memorez1000enjoyer/CASA-EDB/output/renders/exploded.png

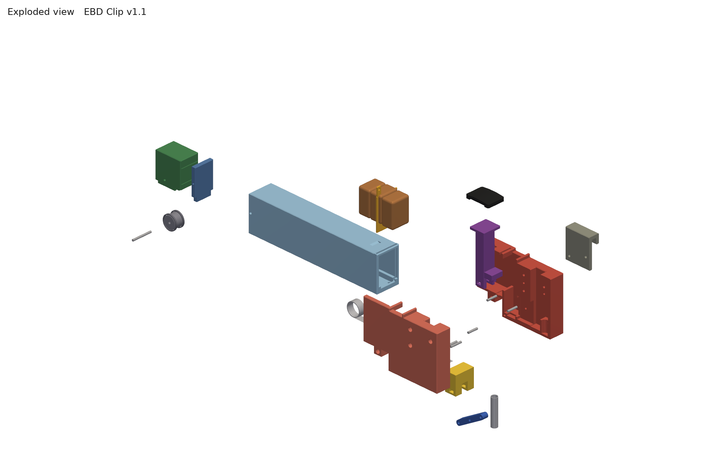
output/renders/exploded.png
