memorez1000enjoyer/CASA-EDB/output/renders/state_A_rest_full_iso_back.png

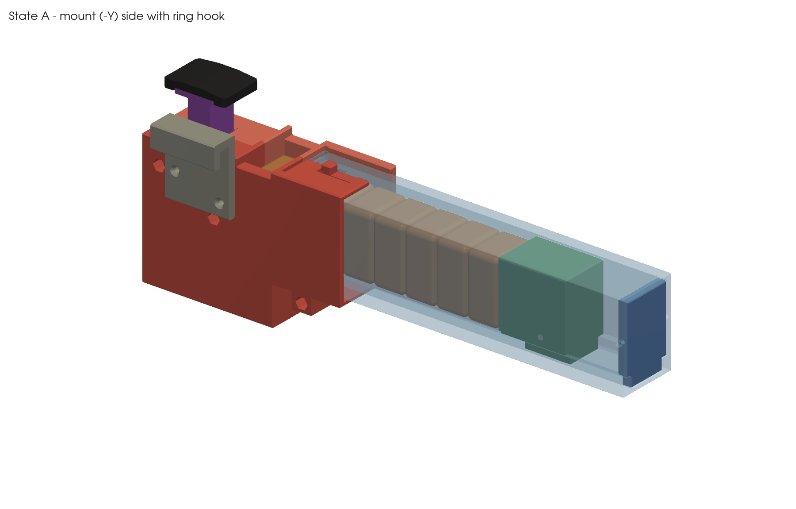
output/renders/state_A_rest_full_iso_back.png
