memorez1000enjoyer/CASA-EDB/output/renders/state_A_rest_full_section_Y0_zoom.png

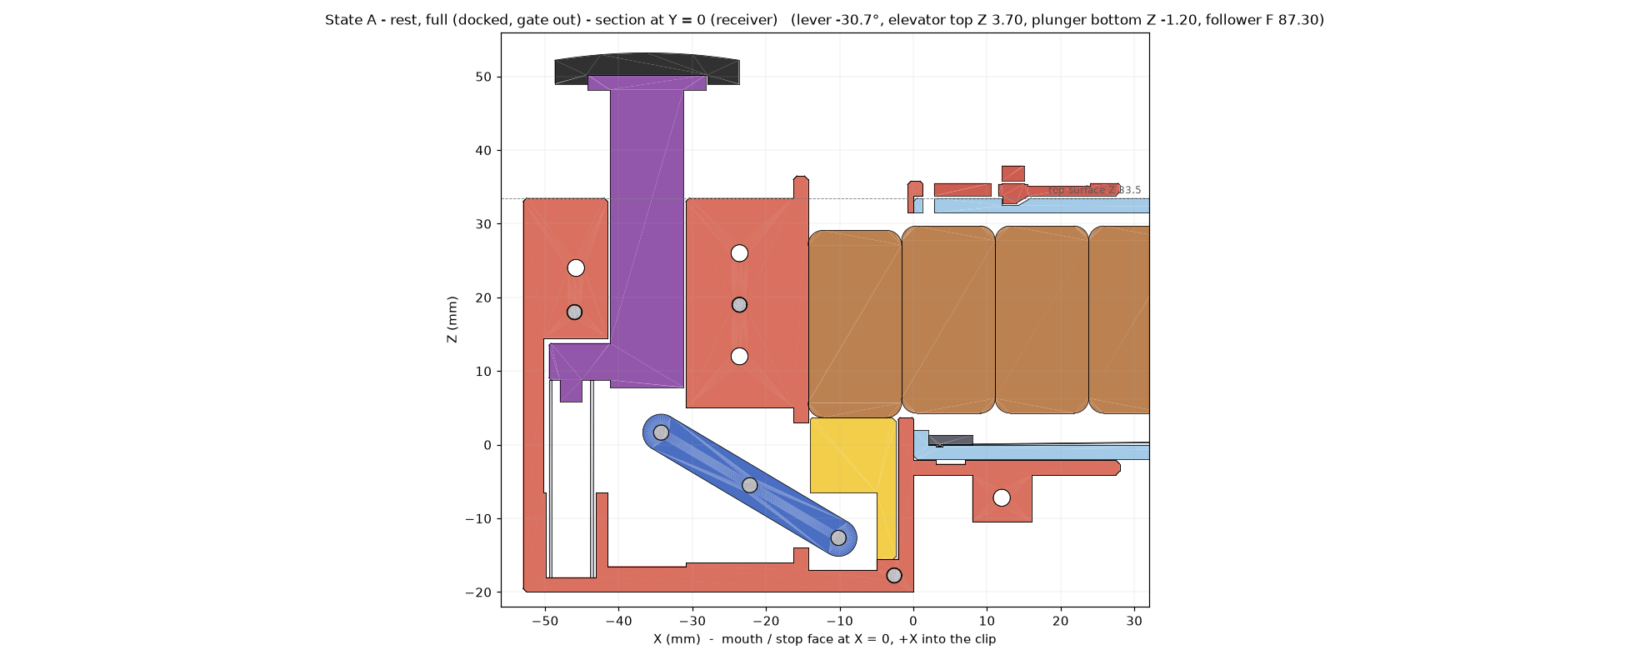
output/renders/state_A_rest_full_section_Y0_zoom.png
