memorez1000enjoyer/CASA-EDB/output/renders/state_Bprime_pressed_bite1_taken_iso.png

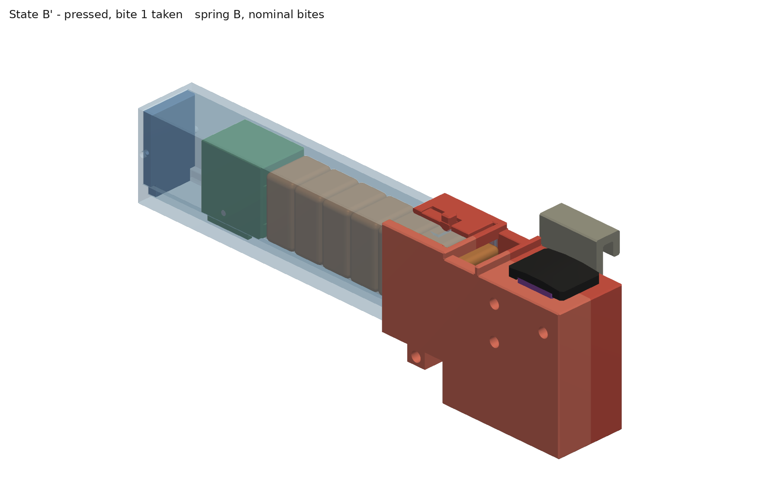
output/renders/state_Bprime_pressed_bite1_taken_iso.png
