memorez1000enjoyer/CASA-EDB/output/renders/state_Bprime_pressed_bite1_taken_section_Y0_zoom.png

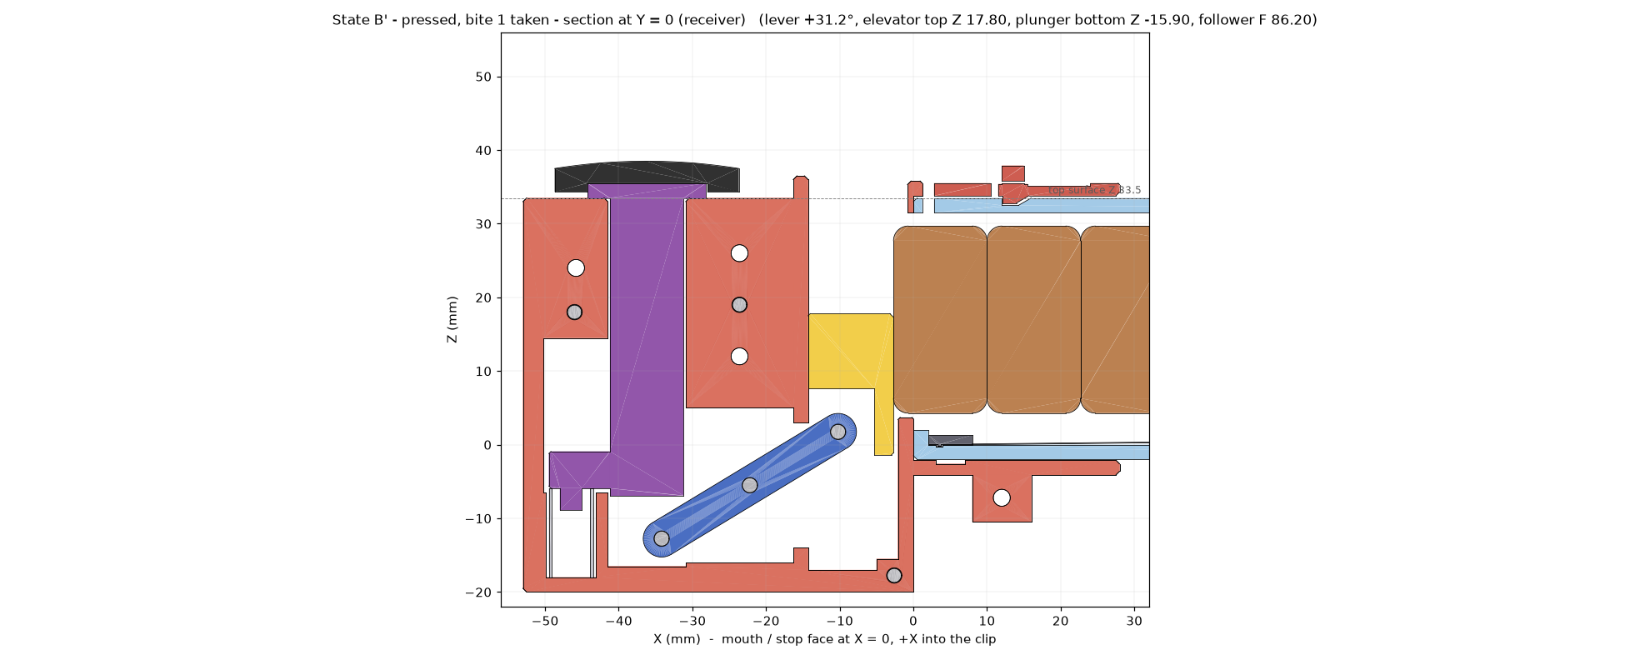
output/renders/state_Bprime_pressed_bite1_taken_section_Y0_zoom.png
