memorez1000enjoyer/CASA-EDB/output/renders/state_C_section_Y0.png

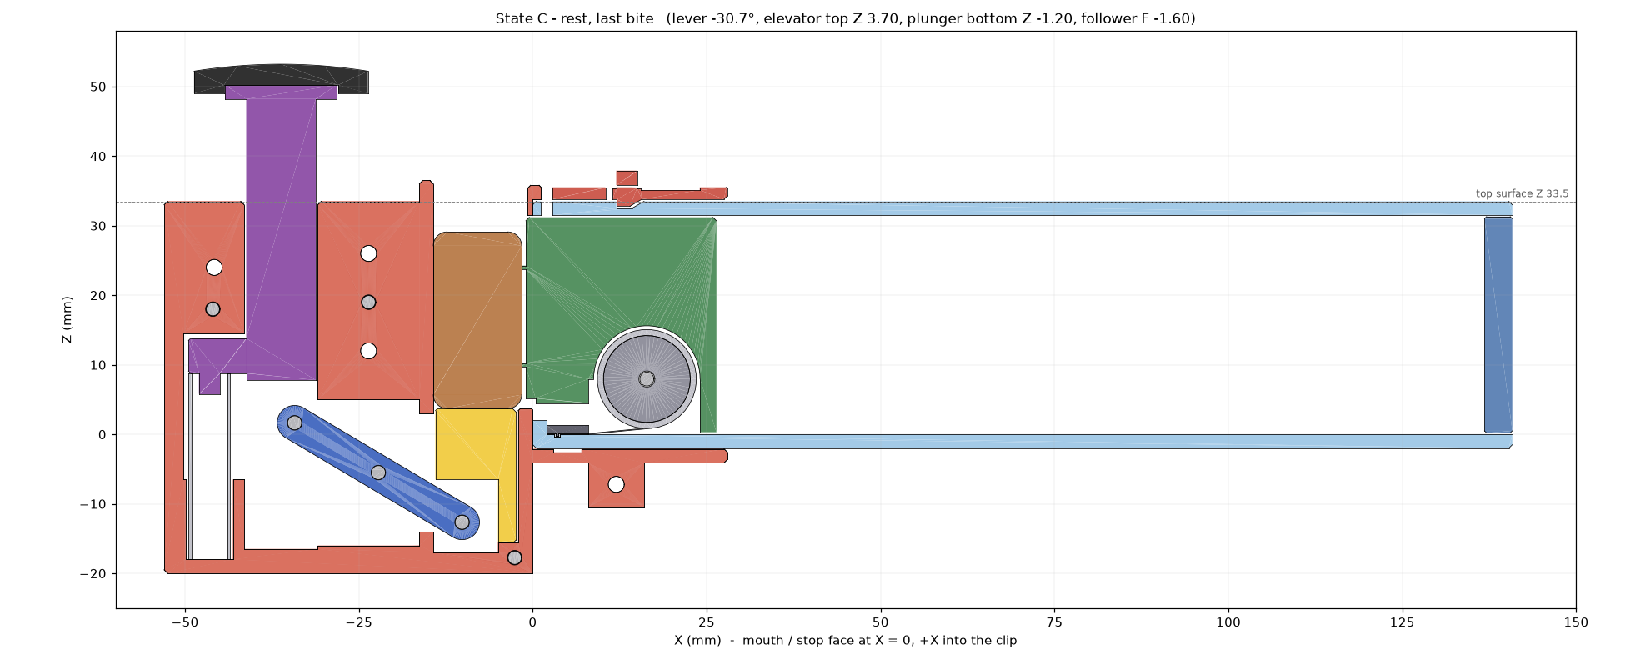
output/renders/state_C_section_Y0.png
