memorez1000enjoyer/CASA-EDB/output/step/parts/end_cap.step

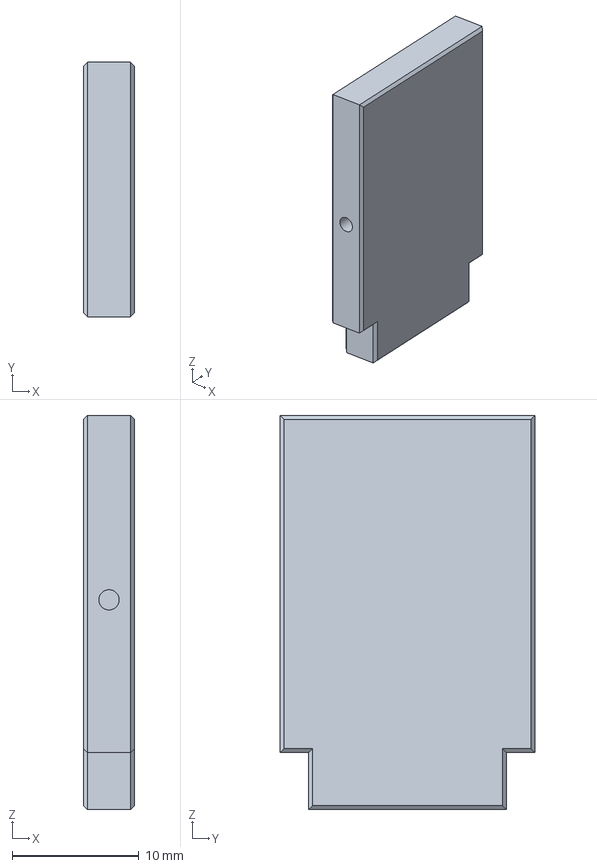
[picture p14: CAD file, 2026-10-06]
output/step/parts/end_cap.step
4.00 x 20.1 x 31.1 mm
