memorez1000enjoyer/CASA-EDB/output/stl/slicer_helpers/receiver_left_SUPPORT_ENFORCER.stl

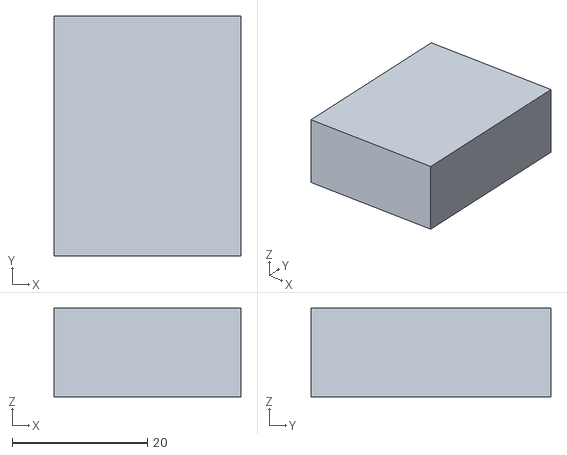
[picture p15: CAD file, 2026-10-06]
output/stl/slicer_helpers/receiver_left_SUPPORT_ENFORCER.stl
27.6 x 35.5 x 13.2
