memorez1000enjoyer/CASA-EDB/output/step/parts/clip_tube.step

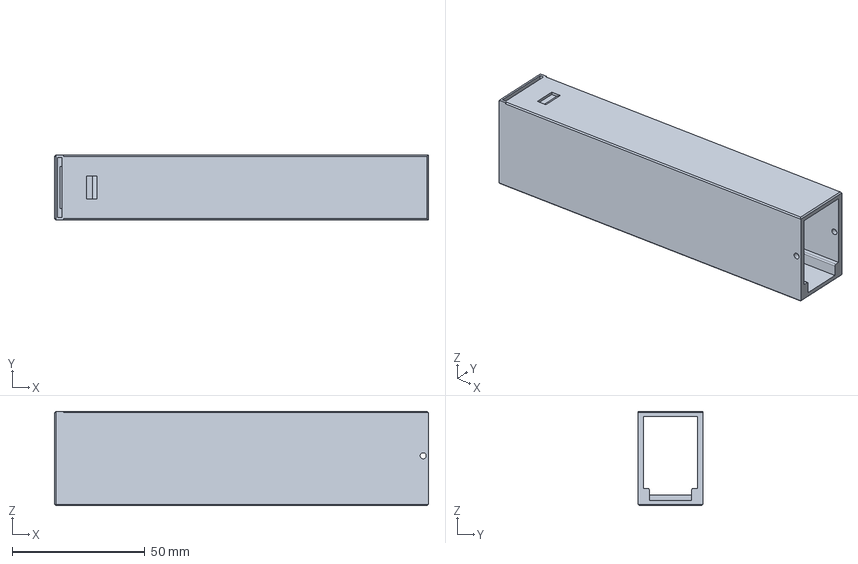
[picture p17: CAD file, 2026-10-06]
output/step/parts/clip_tube.step
140.8 x 24.5 x 35.5 mm
