memorez1000enjoyer/CASA-EDB/output/step/parts/receiver_left.step

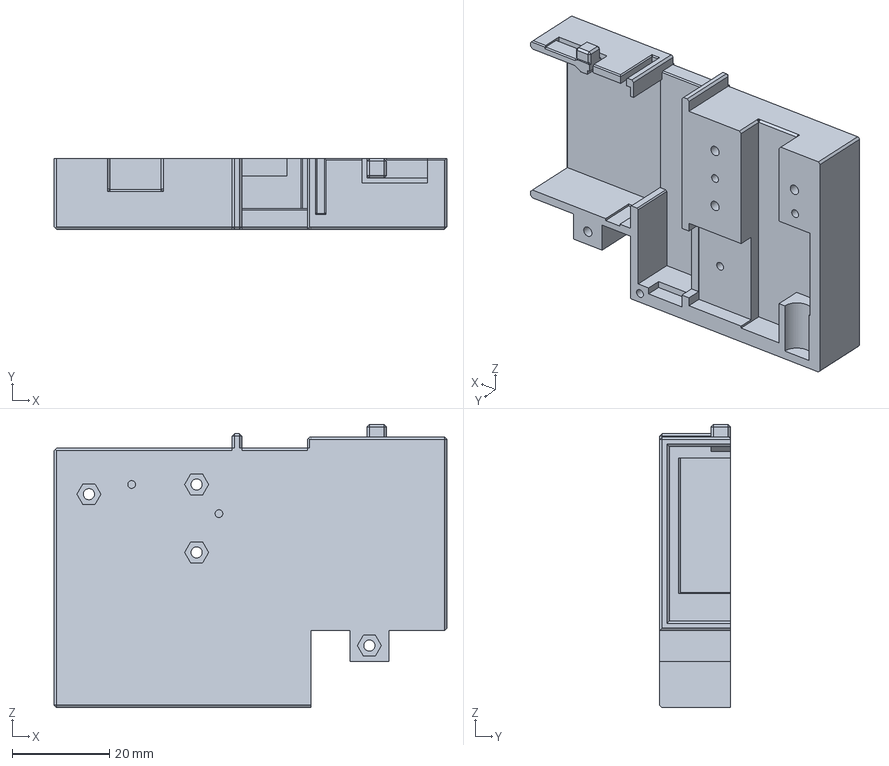
[picture p20: CAD file, 2026-10-06]
output/step/parts/receiver_left.step
81.0 x 14.6 x 58.4 mm
