memorez1000enjoyer/CASA-EDB/output/stl/slicer_helpers/plunger_SUPPORT_ENFORCER.stl

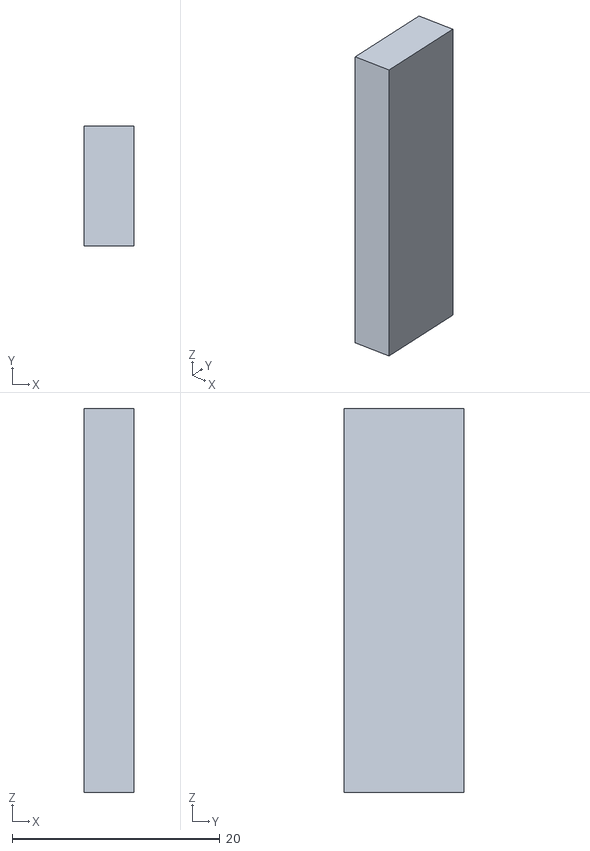
[picture p21: CAD file, 2026-09-29]
output/stl/slicer_helpers/plunger_SUPPORT_ENFORCER.stl
4.80 x 11.6 x 37.0
