memorez1000enjoyer/CASA-EDB/output/step/parts/follower_springA.step

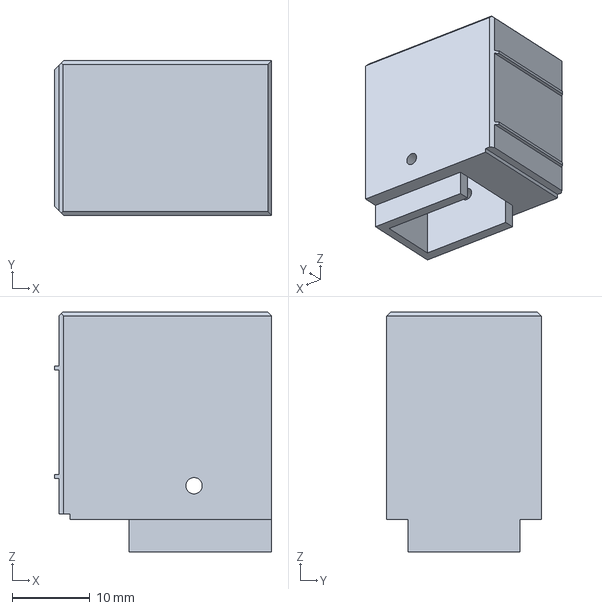
[picture p23: CAD file, 2026-10-06]
output/step/parts/follower_springA.step
28.0 x 19.9 x 30.9 mm
