memorez1000enjoyer/CASA-EDB/output/step/assemblies/state_E_springB_nom.step

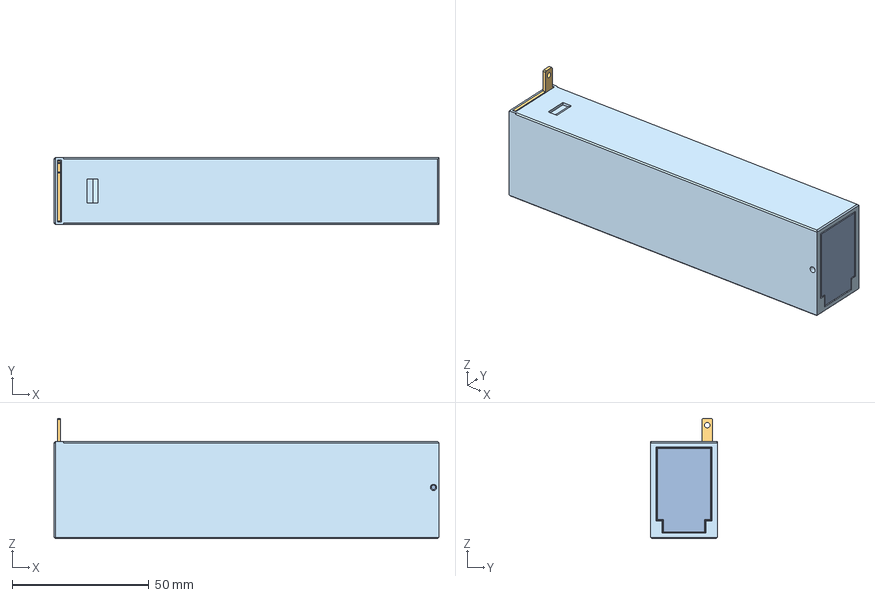
[picture p24: CAD file, 2026-10-06]
output/step/assemblies/state_E_springB_nom.step
140.8 x 24.5 x 44.0 mm
clip_tube
end_cap
ribbon_clamp
screw_clamp_p
screw_clamp_n
gate
follower
drum
pin_axle
drum_spacer1
drum_spacer2
cf_spring
bite1
bite2
bite3
bite4
bite5
bite6
bite7
bite8
