memorez1000enjoyer/CASA-EDB/output/step/parts/plunger.step

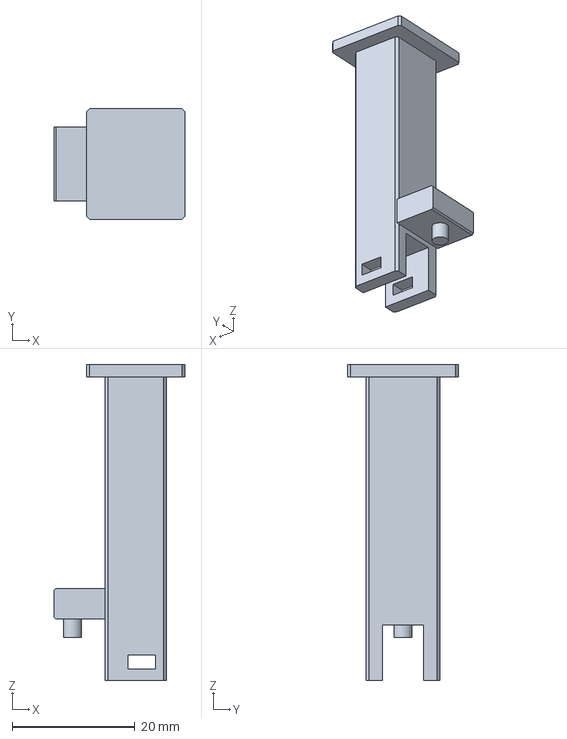
[picture p25: CAD file, 2026-10-06]
output/step/parts/plunger.step
21.3 x 18.0 x 51.4 mm
