memorez1000enjoyer/CASA-EDB/output/step/assemblies/state_Bprime_springB_nom.step

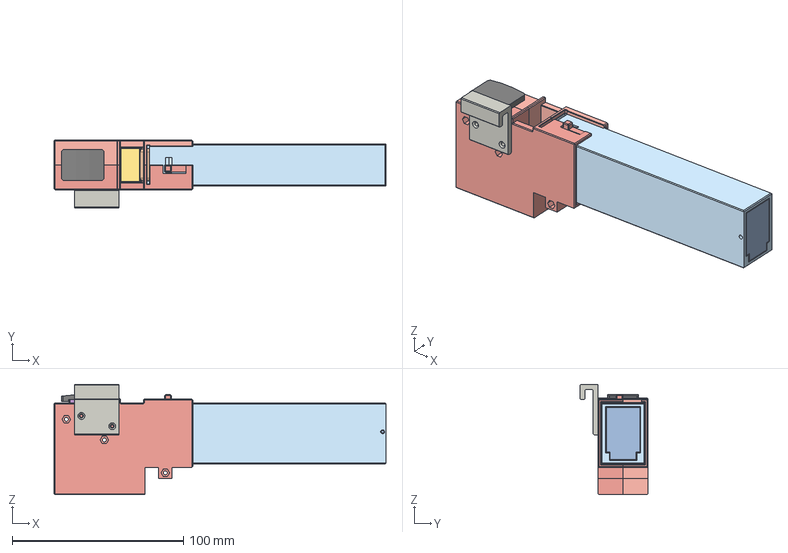
[picture p26: CAD file, 2026-10-06]
output/step/assemblies/state_Bprime_springB_nom.step
193.8 x 39.7 x 64.5 mm
clip_tube
end_cap
ribbon_clamp
screw_clamp_p
screw_clamp_n
follower
drum
pin_axle
drum_spacer1
drum_spacer2
cf_spring
receiver_left
receiver_right
ring_hook
dowel1
dowel2
dowel3
pin_pivot
elevator
lever
pin_cup
pin_plunger
plunger
paddle_pad
return_spring
bite2
bite3
bite4
bite5
bite6
bite7
bite8
