memorez1000enjoyer/CASA-EDB/output/step/parts/gate.step

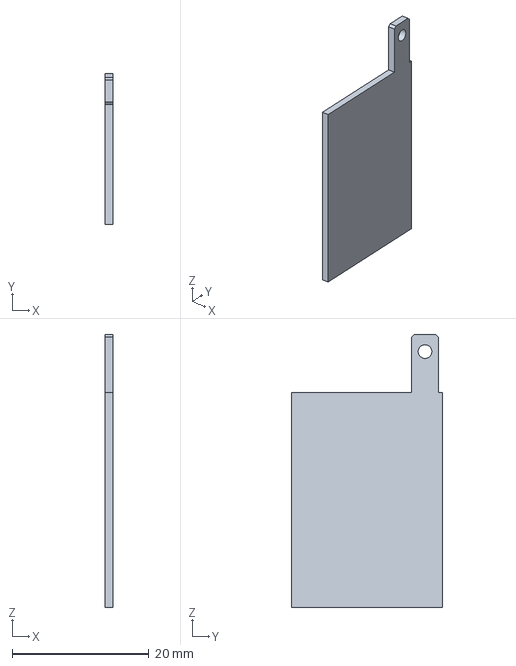
[picture p27: CAD file, 2026-10-06]
output/step/parts/gate.step
1.20 x 22.1 x 40.0 mm
