memorez1000enjoyer/CASA-EDB/output/step/parts/lever.step

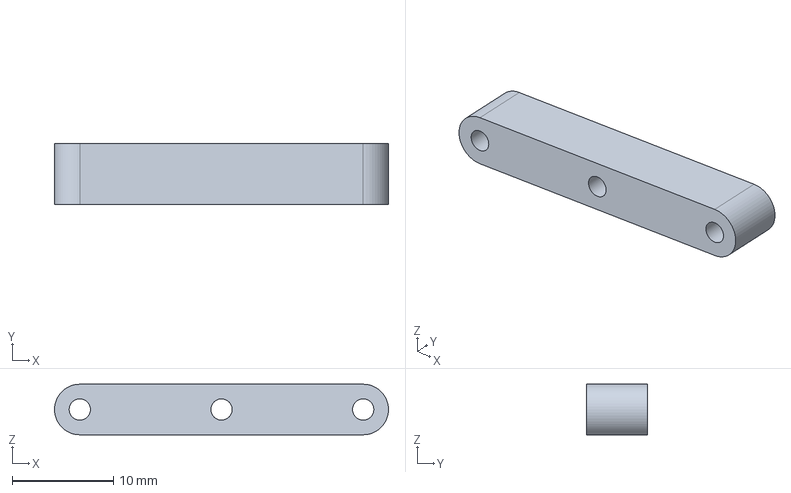
[picture p29: CAD file, 2026-10-06]
output/step/parts/lever.step
33.0 x 6.00 x 5.00 mm
