memorez1000enjoyer/CASA-EDB/output/step/parts/bite_min.step

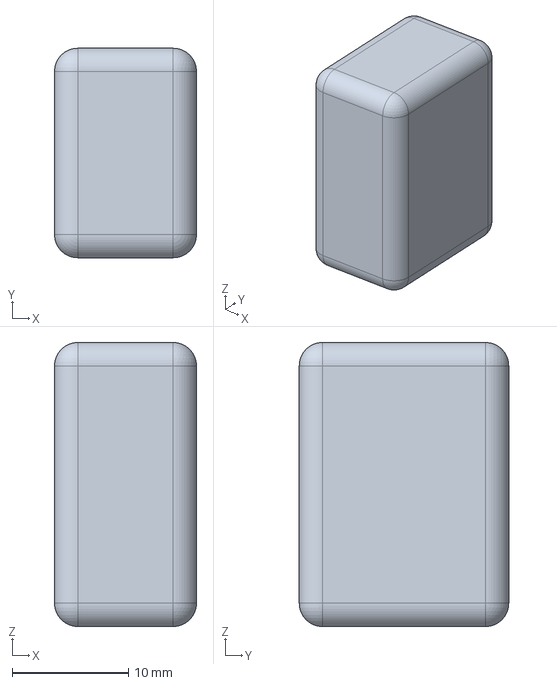
[picture p31: CAD file, 2026-10-06]
output/step/parts/bite_min.step
12.2 x 18.0 x 24.4 mm
