memorez1000enjoyer/CASA-EDB/output/step/parts/bite_max.step

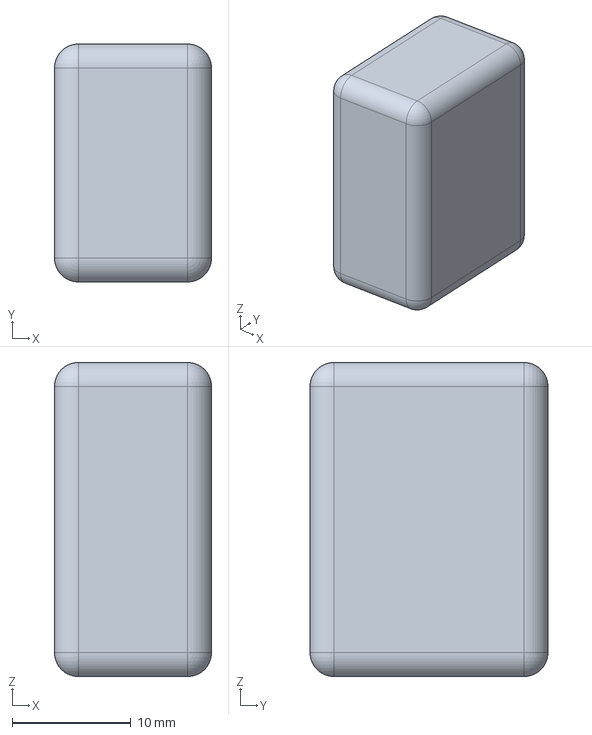
[picture p33: CAD file, 2026-10-06]
output/step/parts/bite_max.step
13.2 x 20.0 x 26.4 mm
