memorez1000enjoyer/CASA-EDB/output/step/parts/ring_hook.step

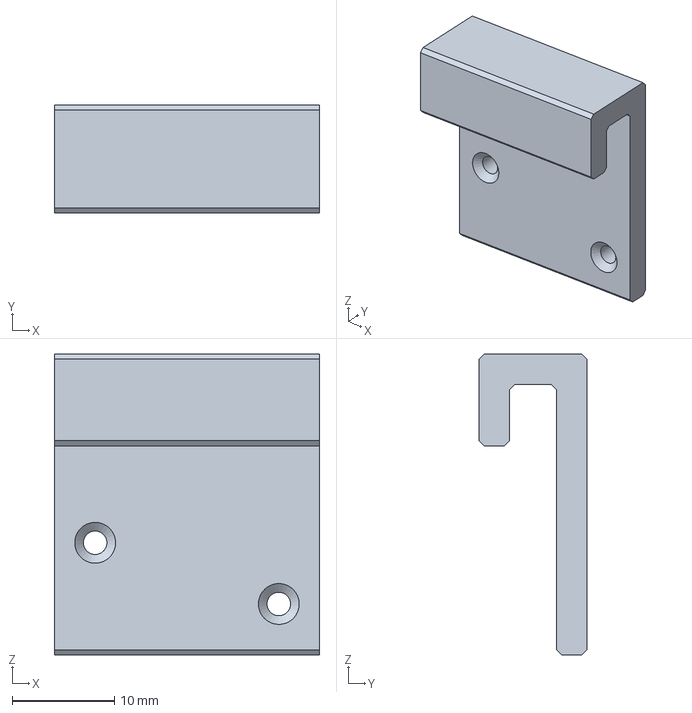
[picture p34: CAD file, 2026-10-06]
output/step/parts/ring_hook.step
26.0 x 10.6 x 29.5 mm
