memorez1000enjoyer/CASA-EDB/output/step/parts/paddle_pad.step

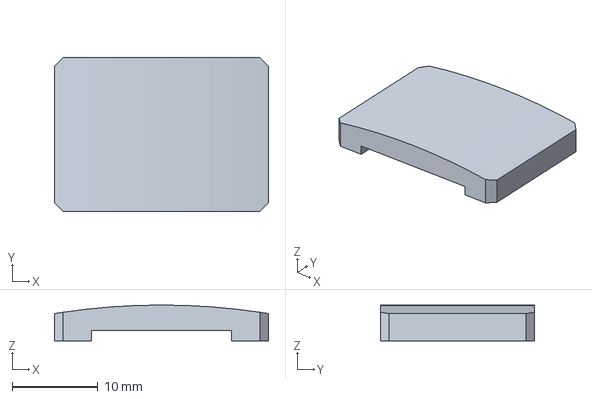
[picture p35: CAD file, 2026-10-06]
output/step/parts/paddle_pad.step
25.0 x 18.0 x 4.20 mm
