memorez1000enjoyer/CASA-EDB/output/step/parts/elevator.step

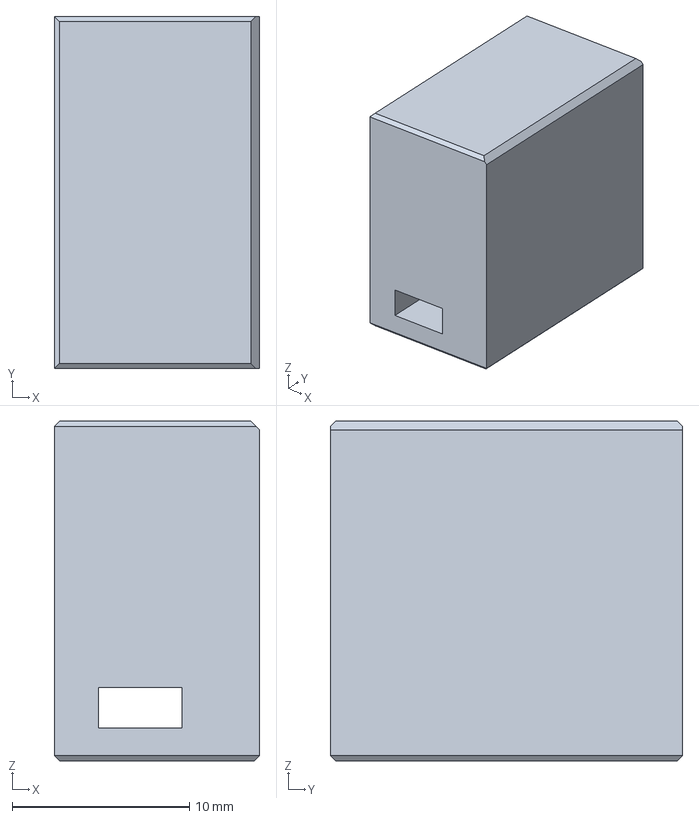
[picture p36: CAD file, 2026-10-06]
output/step/parts/elevator.step
11.6 x 19.9 x 19.2 mm
