memorez1000enjoyer/CASA-EDB/output/step/parts/bench_base.step

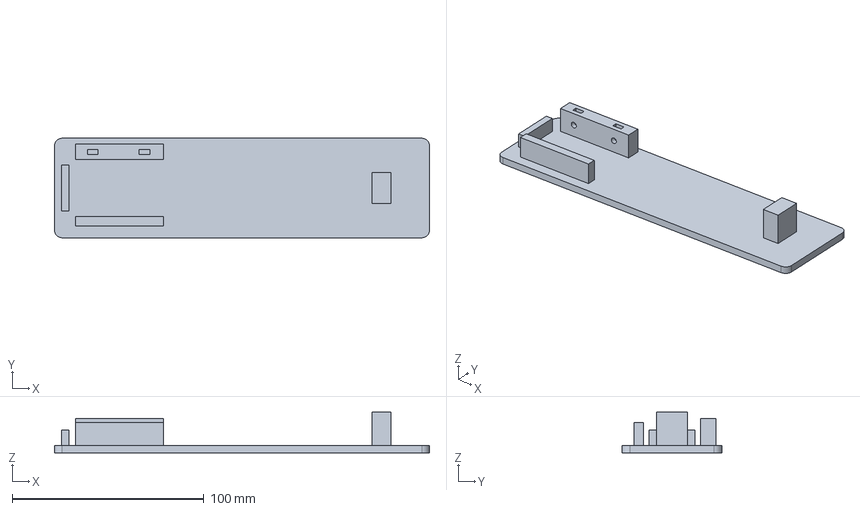
[picture p37: CAD file, 2026-10-06]
output/step/parts/bench_base.step
195.8 x 52.0 x 21.4 mm
