memorez1000enjoyer/CASA-EDB/output/step/parts/follower.step

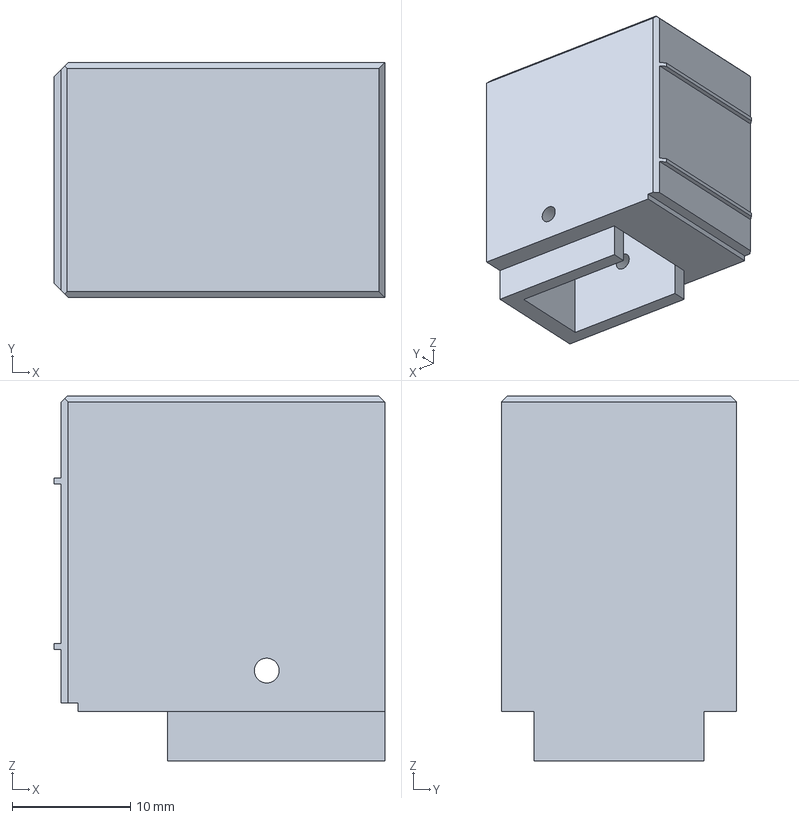
[picture p38: CAD file, 2026-10-06]
output/step/parts/follower.step
28.0 x 19.9 x 30.9 mm
