memorez1000enjoyer/CASA-EDB/output/step/parts/bite_wedge_test.step

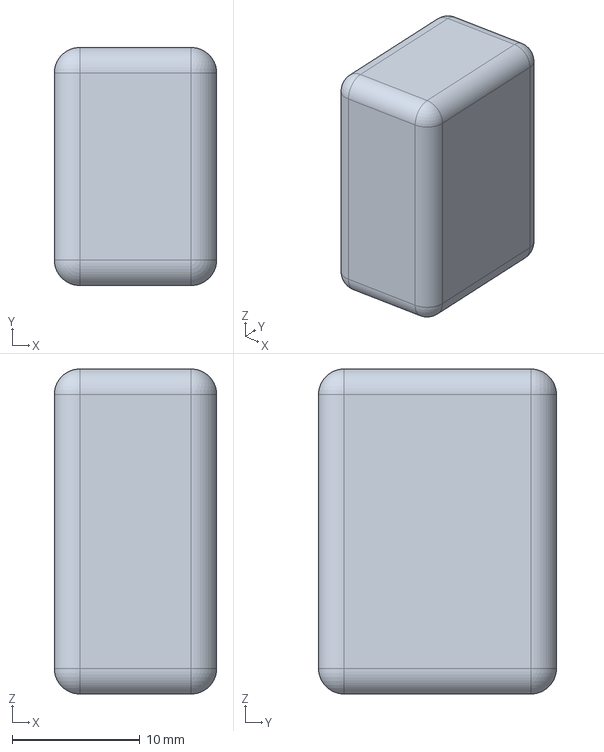
[picture p39: CAD file, 2026-10-06]
output/step/parts/bite_wedge_test.step
12.7 x 18.6 x 25.4 mm
