memorez1000enjoyer/CASA-EDB/output/step/parts/receiver_right.step

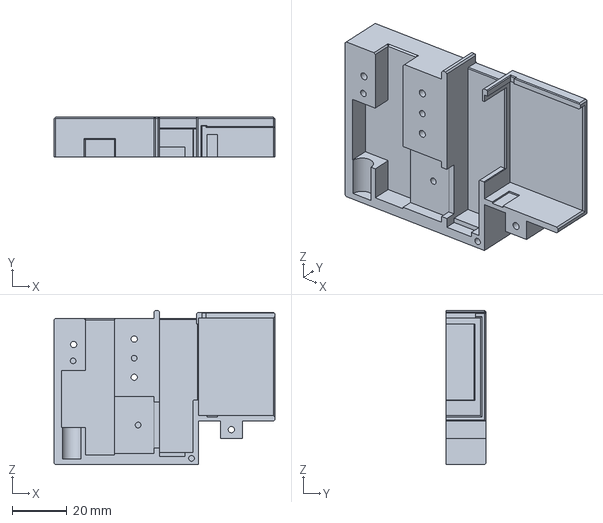
[picture p40: CAD file, 2026-10-06]
output/step/parts/receiver_right.step
81.0 x 14.6 x 56.5 mm
