memorez1000enjoyer/CASA-EDB/output/step/parts/ribbon_clamp.step

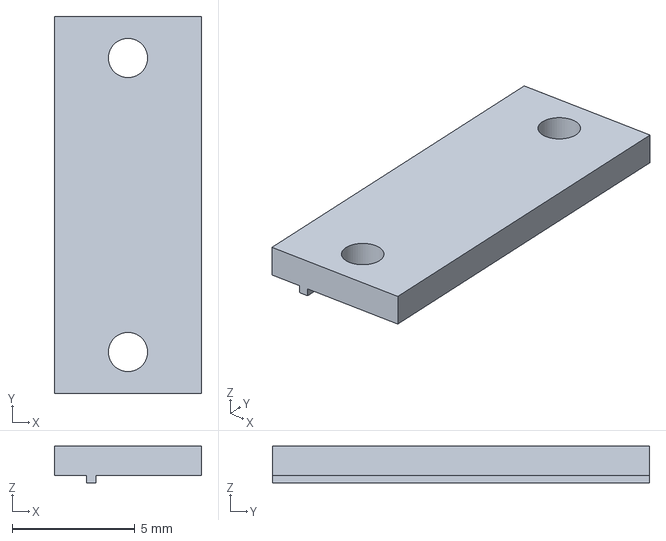
[picture p41: CAD file, 2026-10-06]
output/step/parts/ribbon_clamp.step
6.00 x 15.4 x 1.50 mm
