memorez1000enjoyer/CASA-EDB/output/step/parts/drum.step

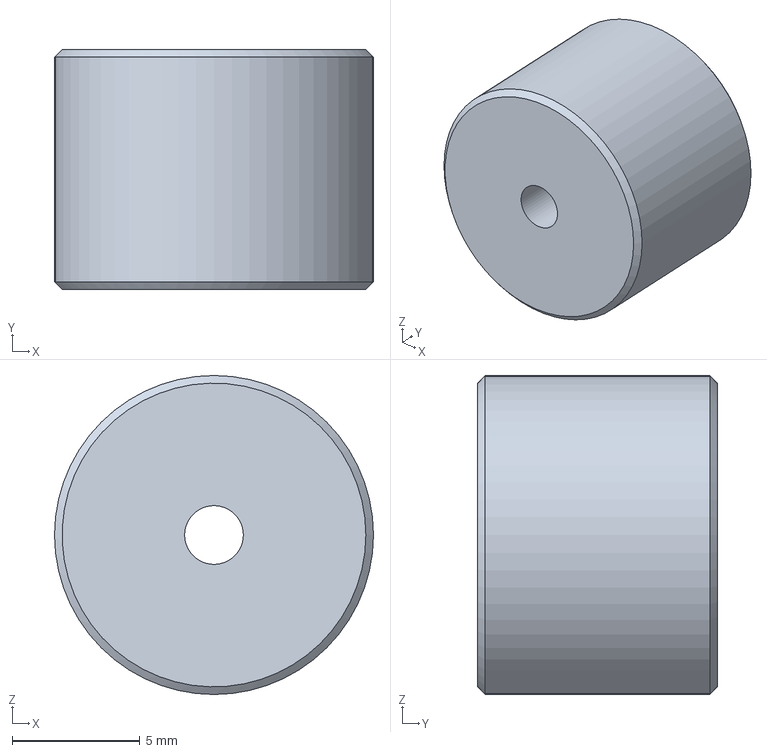
[picture p42: CAD file, 2026-10-06]
output/step/parts/drum.step
12.5 x 9.40 x 12.5 mm
