memorez1000enjoyer/CASA-EDB/output/step/parts/drum_spacer.step

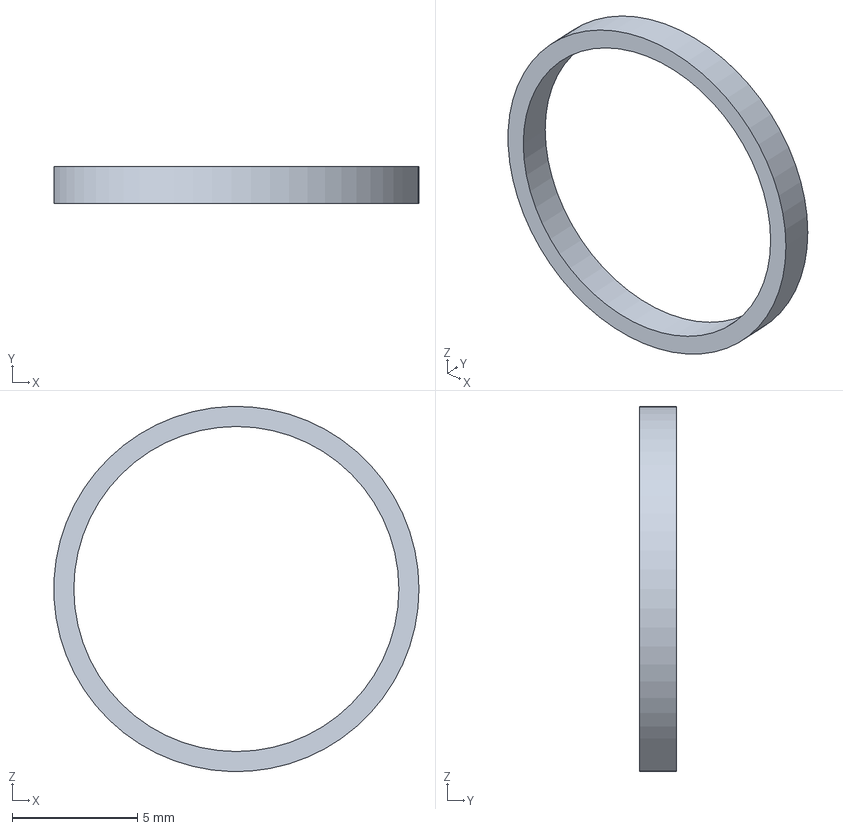
[picture p43: CAD file, 2026-10-06]
output/step/parts/drum_spacer.step
14.6 x 1.48 x 14.6 mm
