memorez1000enjoyer/CASA-EDB/output/step/parts/fit_coupon.step

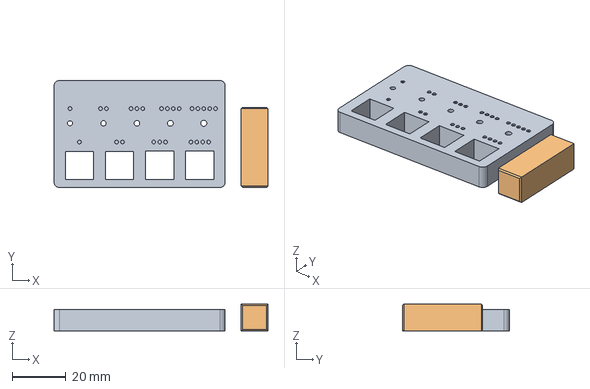
[picture p44: CAD file, 2026-10-06]
output/step/parts/fit_coupon.step
80.0 x 40.0 x 10.0 mm
