memorez1000enjoyer/CASA-EDB/(list of files, cad)

Other CAD files:
output/step/parts/clip_tube_viewslots.step
output/step/parts/bite_nominal.step
output/step/parts/drum_spacer_springB.step
output/step/parts/follower_springB.step
output/stl/assemblies/state_A_springA_nom.stl
output/stl/assemblies/state_A_springB_nom.stl
output/stl/assemblies/state_B_springB_nom.stl
output/stl/assemblies/state_Bprime_springA_nom.stl
output/stl/assemblies/state_Bprime_springB_nom.stl
output/stl/assemblies/state_C_springB_nom.stl
output/stl/assemblies/state_D_springB_nom.stl
output/stl/assemblies/state_D_taken_springB_nom.stl
output/stl/assemblies/state_E_springB_nom.stl
output/stl/bench_base.stl
output/stl/bite_max.stl
output/stl/bite_min.stl
output/stl/bite_nominal.stl
output/stl/bite_wedge_test.stl
output/stl/clip_tube.stl
output/stl/clip_tube_viewslots.stl
output/stl/drum.stl
output/stl/drum_spacer.stl
output/stl/elevator.stl
output/stl/end_cap.stl
output/stl/fit_coupon.stl
output/stl/follower.stl
output/stl/follower_springA.stl
output/stl/gate.stl
output/stl/lever.stl
output/stl/paddle_pad.stl
output/stl/plunger.stl
output/stl/receiver_left.stl
output/stl/receiver_right.stl
output/stl/ribbon_clamp.stl
output/stl/ring_hook.stl
