memorez1000enjoyer/CASA-EDB/output/VERIFICATION.md

# VERIFICATION - EBD Clip v1.1

Generated by `cad/verify.py` on 2026-10-06 02:41 (full run: springs B (default) and A x bites min/nom/max; geometry checks took 204 s). Every number comes from the CAD model or from `params.py`.

Spec: EBD_Build_Spec.md Rev C, section 9, plus the v1.1 follow-up checks (§9.11-9.13). Units mm, N. Bites: min 12.2 x 18.0 x 24.4, nom 12.7 x 19.0 x 25.4, max 13.2 x 20.0 x 26.4 (T x W x H).

## Summary

| § | Check | Result | Key numbers |
|---|---|---|---|
| 9.1 | Interference (all states + lever sweep) | PASS | 258 poses checked, 0 unintended overlaps > 0.01 mm³ |
| 9.2 | One-bite rule | PASS | bite-2-top to roof min 0.65 (≥ 0.6); elevator top never under bite 2 |
| 9.3 | Exposure | PASS | min exposure 8.50 with pin-hole play (≥ 8.0), min retained 15.90 (≥ 12) |
| 9.4 | Window | PASS | X clearance min 0.30, Y/side min 0.25, bite 2 under window max 1.90 (≤ 1.9) |
| 9.5 | Follower | PASS | stops at F = -1.60 on the clamp back edge; ribbon max Z 1.33 (< 2.0) |
| 9.6 | Spring extension | PASS | min with ≥ 2 bites 20.4 (≥ 18); last bite 9.1-9.7; max 118.1 |
| 9.7 | Kinematics | PASS | lift 14.10 model / 13.90 with pin-hole play (≥ 13.5), stroke 14.70, pins inside slots (min margin 0.18 at nominal X) |
| 9.8 | Printability | **FLAG** (supports) | 22 STLs all watertight, walls ≥ 0.8 except listed spec features; NEEDS SUPPORT: receiver_left, receiver_right, plunger (OPEN_ISSUES #2) |
| 9.9 | Envelope / mass report | PASS | reported below |
| 9.10 | Force report | REPORT (A > 6 N; **B feed < 1.0 on Earth at ~32° if bites lean**) | B 2.2-4.1 N, uneaten bite returns 1.95x (sticky 1.26x); A 4.9-7.9 N (> 6 N flagged, does not return); B feed margin, min width: 1.82x level / 1.24x vertical / **1.02x at 56°**, leaning bites **0.66x at 32°** (worst width 18.59: **0.79x level**); Moon ≥ 4.0x any orientation |
| 9.11 | Bites step down into the receiver (v1.1) | PASS | smallest step-down 0.20 (min width, clip dz -0.1); bridge and cup at rest both Z 3.70 |
| 9.12 | Return-spring solid length (v1.1) | PASS | B 5.6 / A 4.1 (≤ 10, pressed length 12.1) for Ø0.4 wire, OD 6.0 |
| 9.13 | Latch engagement (v1.1) | PASS (report) | 0.60 with the clip on its floor; tooth to notch floor 0.00 with the clip floated up 0.3 |

## 9.1 Interference

Exact B-rep booleans (OpenCascade) between every pair of bodies whose bounding boxes come within 1 mm, in states A, B, B', C, D, D-taken, E, plus 7 intermediate lever angles for each of the B, B' and D strokes, plus states C and D-taken with the clip shifted ±0.3 in Y, down 0.1 (on its socket floor) and up 0.3 (against the socket roof), plus full stacks in states A, B and B' with the clip on its socket floor and A, B' with the clip ±0.3 off-centre in Y (bites on the rails ride with the clip), for each configuration. Threshold 0.01 mm³. Intended overlaps are excluded and listed: dowel / receiver_left: Ø2 dowel pressed into Ø1.9 hole; pin_pivot / receiver_left: Ø2 pivot pin pressed into Ø1.9 hole; screw_clamp / ribbon_clamp: M2 self-tapper threads into Ø1.6 pilot.

**No unintended overlap in any of the 258 poses.**

### Minimum clearance of every pair that includes a moving body (worst case over all configs and poses)

| Pair | Min clearance | Where | Note |
|---|---|---|---|
| clip_tube / follower | 0.000 | B/min A | contact (designed) |
| cf_spring / clip_tube | 0.000 | B/min A | contact (designed) |
| cf_spring / ribbon_clamp | 0.000 | B/min A | contact (designed) |
| bite / follower | 0.000 | B/min A | contact (designed) |
| cf_spring / drum | 0.000 | B/min A | contact (designed) |
| elevator / receiver_left | 0.000 | B/min A | contact (designed) |
| plunger / receiver_left | 0.000 | B/min B | contact (designed) |
| receiver_left / return_spring | 0.000 | B/min A | contact (designed) |
| bite / receiver_left | 0.000 | B/min A | contact (designed) |
| elevator / receiver_right | 0.000 | B/min A | contact (designed) |
| plunger / receiver_right | 0.000 | B/min B | contact (designed) |
| receiver_right / return_spring | 0.000 | B/min A | contact (designed) |
| bite / receiver_right | 0.000 | B/min A | contact (designed) |
| elevator / pin_cup | 0.000 | B/min A | contact (designed) |
| bite / elevator | 0.000 | B/min A | contact (designed) |
| pin_plunger / plunger | 0.000 | B/min A | contact (designed) |
| paddle_pad / plunger | 0.000 | B/min A | contact (designed) |
| plunger / return_spring | 0.000 | B/min A | contact (designed) |
| bite / bite | 0.000 | B/min A | contact (designed) |
| follower / ribbon_clamp | 0.000 | B/min C | contact (designed) |
| follower / receiver_left | 0.000 | B/min C clip dy+0.0 dz+0.3 | contact (designed) |
| follower / receiver_right | 0.000 | B/min C clip dy+0.0 dz+0.3 | contact (designed) |
| bite / gate | 0.000 | B/min E | contact (designed) |
| bite / clip_tube | 0.000 | B/min Bp clip dy+0.3 dz+0.0 | contact (designed) |
| follower / pin_axle | 0.050 | B/min Bp clip dy+0.3 dz+0.0 |  |
| cf_spring / drum_spacer | 0.050 | B/min Bp clip dy+0.3 dz+0.0 |  |
| lever / pin_pivot | 0.050 | B/min D@+23.5 |  |
| lever / pin_cup | 0.050 | B/min D@+15.7 |  |
| lever / pin_plunger | 0.050 | B/min D@+23.5 |  |
| drum / pin_axle | 0.150 | B/min A clip dy+0.3 dz+0.0 |  |
| cf_spring / screw_clamp | 0.175 | A/min Bp clip dy+0.3 dz+0.0 |  |
| drum / drum_spacer | 0.250 | B/min Bp clip dy+0.3 dz+0.0 |  |
| clip_tube / pin_axle | 0.300 | B/min A |  |
| elevator / lever | 0.300 | B/min D@+23.5 |  |
| lever / plunger | 0.300 | B/min D@+23.5 |  |
| drum_spacer / follower | 0.350 | B/min Bp clip dy+0.3 dz+0.0 |  |
| cf_spring / follower | 0.475 | A/min Bp clip dy+0.3 dz+0.0 |  |
| lever / receiver_left | 0.500 | B/min A |  |
| lever / receiver_right | 0.500 | B/min A |  |
| pin_cup / receiver_left | 0.550 | B/min A |  |
| pin_cup / receiver_right | 0.550 | B/min A |  |
| drum / follower | 0.600 | B/min Bp clip dy+0.3 dz+0.0 |  |
| pin_plunger / receiver_left | 0.600 | B/min D@+23.5 |  |
| pin_plunger / receiver_right | 0.600 | B/min D@+23.5 |  |
| clip_tube / drum_spacer | 0.650 | B/min Bp clip dy+0.3 dz+0.0 |  |
| paddle_pad / receiver_left | 0.800 | B/min Bp clip dy+0.3 dz+0.0 |  |
| paddle_pad / receiver_right | 0.800 | B/min Bp clip dy+0.3 dz+0.0 |  |
| elevator / follower | 0.800 | B/min D |  |
| end_cap / follower | 0.800 | B/max E |  |
| cf_spring / receiver_left | 1.703 | B/min C clip dy+0.0 dz-0.1 |  |
| cf_spring / receiver_right | 1.703 | B/min C clip dy+0.0 dz-0.1 |  |
| clip_tube / drum | 1.705 | B/min A |  |
| cf_spring / gate | 1.850 | A/min E |  |
| follower / screw_clamp | 2.000 | B/min C |  |
| pin_axle / receiver_left | 2.300 | B/min C clip dy-0.3 dz+0.0 |  |
| pin_axle / receiver_right | 2.300 | B/min C clip dy+0.3 dz+0.0 |  |
| drum_spacer / receiver_left | 2.650 | B/min Dt clip dy+0.0 dz-0.1 |  |
| drum_spacer / receiver_right | 2.650 | B/min Dt clip dy+0.0 dz-0.1 |  |
| bite / cf_spring | 2.907 | A/min E |  |
| dowel / plunger | 3.200 | B/min A clip dy+0.3 dz+0.0 |  |
| drum / receiver_left | 3.705 | B/min C clip dy+0.0 dz-0.1 |  |
| drum / receiver_right | 3.705 | B/min C clip dy+0.0 dz-0.1 |  |
| cf_spring / pin_axle | 5.250 | B/min Bp clip dy+0.3 dz+0.0 |  |
| drum_spacer / pin_axle | 5.500 | B/min A |  |
| bite / lever | 10.185 | B/min A clip dy+0.3 dz+0.0 |  |

## Per-configuration numbers (§9.2 - §9.6)

| Config | bite-2 top→roof (A/B) | bite-2 top→roof (B') | bite 2 seat Z (A) | elevator top rear edge → bite 2, nominal / elevator pushed back 0.3 | exposure above 33.5 | retained below 33.5 | window X clr | window Y clr/side | bite 2 under window (B') |
|---|---|---|---|---|---|---|---|---|---|
| B/min | 3.10 | 3.10 | 4.000 | 0.30 / 0.00 | 8.70 | 15.70 | 1.30 | 1.25 | 1.90 |
| B/nom | 1.81 | 1.81 | 4.291 | 0.80 / 0.50 | 9.70 | 15.70 | 0.80 | 0.75 | 1.90 |
| B/max | 0.65 | 0.65 | 4.450 | 1.30 / 1.00 | 10.70 | 15.70 | 0.30 | 0.25 | 1.90 |
| A/min | 3.10 | 3.10 | 4.000 | 0.30 / 0.00 | 8.70 | 15.70 | 1.30 | 1.25 | 1.90 |
| A/nom | 1.81 | 1.81 | 4.291 | 0.80 / 0.50 | 9.70 | 15.70 | 0.80 | 0.75 | 1.90 |
| A/max | 0.65 | 0.65 | 4.450 | 1.30 / 1.00 | 10.70 | 15.70 | 0.30 | 0.25 | 1.90 |

Notes: bites are modelled upright (leaning bites: §9.11) and settle vertically onto the highest support (rails 4.0/4.29/4.45, bridge and cup 3.7). A bite overhanging the bridge stays on the rails (the bridge is below every rail seat). "Elevator top rear edge → bite 2" is the X gap between the cup floor's rear edge and bite 2's front face in states A/B; it must stay ≥ 0 so the cup is never under bite 2.

| Config | F (A) | F (B') | F (C) | F (E) | follower back → end cap (E) | ribbon free length: A / 2 bites / last bite / E / max (limit) | coil OD at E / pocket Ø | ribbon max Z |
|---|---|---|---|---|---|---|---|---|
| B/min | 83.30 | 82.70 | -1.60 | 100.00 | 8.80 | 93.4 / 20.4 / 9.1 / 110.1 / 110.1 (305) | 13.78 / 15.31 | 1.16 |
| B/nom | 87.30 | 86.20 | -1.60 | 104.00 | 4.80 | 97.4 / 21.4 / 9.1 / 114.1 / 114.1 (305) | 13.76 / 15.31 | 1.17 |
| B/max | 91.30 | 89.70 | -1.10 | 108.00 | 0.80 | 101.4 / 22.4 / 9.6 / 118.1 / 118.1 (305) | 13.75 / 15.31 | 1.18 |
| A/min | 83.30 | 82.70 | -1.60 | 100.00 | 8.80 | 93.4 / 20.5 / 9.2 / 110.1 / 110.1 (457) | 15.36 / 17.06 | 1.30 |
| A/nom | 87.30 | 86.20 | -1.60 | 104.00 | 4.80 | 97.4 / 21.4 / 9.2 / 114.1 / 114.1 (457) | 15.33 / 17.06 | 1.32 |
| A/max | 91.30 | 89.70 | -1.10 | 108.00 | 0.80 | 101.4 / 22.4 / 9.7 / 118.1 / 118.1 (457) | 15.31 / 17.06 | 1.33 |

§9.5: the keel legs stop on the clamp back edge at F = -1.60; the keel front never gets closer than X 8.0 to the mouth, so it cannot reach the clamp screws (X 4.0-6.0) or the gate slot (X 1.2-2.8); the follower body (28 long) spans the 1.6 gate-slot gap in the rails. With the last bite taken (state D) the push ribs are 0.80 from the elevator rear face at nominal elevator X (0.50 if the elevator sits at the back of its 0.3 play).

§9.6: extension = free ribbon from the clamp back edge (X 8.0) to the tangent on the coil. "2 bites" is the rest state with two bites left, the shortest extension while ≥ 2 bites remain. Last bite (state C) is reduced force, accepted per spec - confirm on the bench.

## 9.7 Kinematics

- Lever pivot (-22.2, -5.5), arms 14.0. Slot play is taken up in the loaded direction (return spring at rest, chin when pressed).
- Rest: lever -30.71° (cup end down), elevator top Z 3.70 on its ledge, plunger bottom Z -1.20, flange underside Z 48.20.
- Pressed (flange on the top surface): lever 31.19°, plunger bottom Z -15.90, elevator top Z 17.80.
- **Paddle stroke 14.70** (hard stop), **elevator lift 14.10** with pins at hole centres. Lost motion from the two 2.3 slots = 0.60.
- **With the round-hole clearances as well** (lever pivot Ø2.1 on a pin pressed into receiver_left, end holes Ø2.1): each hole sits off its pin by its radial clearance on the loaded side, which takes 0.20 off the lift and adds it to the stroke (rest is set by the ledge, pressed by the hard stop). **Real lift 13.90** (≥ 13.5 PASS), **real paddle stroke 14.90**, flange underside at rest Z 48.40.
- Cup-end pin X range over the sweep -10.223 → -8.200; elevator slot allows -10.50 → -7.80 (square-ended slot, Ø2 pin).
- Plunger-end pin X range -36.200 → -34.177; plunger slot allows -36.50 → -34.00.

| Elevator / plunger X position in its 0.3 play | min margin, cup pin to elevator slot end | min margin, plunger pin to plunger slot end |
|---|---|---|
| -0.3 (against the front wall / -X) | 0.100 | -0.123 |
| nominal (centred) | 0.277 | 0.177 |
| +0.3 (+X) | -0.023 | 0.000 |

A negative margin at the extremes of the X play means the pin reaches the slot end and nudges the part within its 0.3 play (it cannot bind: the play is bigger than the overrun). In B' (elevator pushed forward 0.3 by bite 2) the cup pin margin is shown in the -0.3 row.

## 9.8 Printability

Every STL in `stl/` is loaded with trimesh in its print orientation. Wall thickness is measured by casting a ray inward from ~20k surface samples (shape-diameter); spec-defined sub-0.8 features (push ribs, clamp ridge, 0.5 grooves) are listed, not failed. Overhangs: every downward face steeper than 45° that is not on the bed must be within 1.0 of a supported edge or bridge ≤ 25 between two supported edges.

| STL | Orientation | Watertight / consistent | Shells | Volume cm³ | Min wall | Overhangs | Flags |
|---|---|---|---|---|---|---|---|
| clip_tube | bottom_down | yes | 1 | 34.09 | 0.81  | OK | spec feature: rail stub in front of the gate slot: 1.2 lip with the spec 0.5 rail chamfer 0.78; spec feature: top corner of the 1.2 mouth lip with the spec 0.5 mouth chamfer 0.70; spec feature: clamp notch (X 3.1-3.9) meets the Ø2.3 screw holes (X 3.85-6.15): spec overlap 0.05, not a wall 0.01; longest bridge 20.5 |
| clip_tube_viewslots | bottom_down | yes | 1 | 33.37 | 0.81  | OK | spec feature: top corner of the 1.2 mouth lip with the spec 0.5 mouth chamfer 0.71; spec feature: clamp notch (X 3.1-3.9) meets the Ø2.3 screw holes (X 3.85-6.15): spec overlap 0.05, not a wall 0.03; longest bridge 20.5 |
| gate | plusX_down | yes | 1 | 0.87 | 1.00  | OK | - |
| end_cap | plusX_down | yes | 1 | 2.39 | 1.09  | OK | - |
| follower | plusX_down | yes | 1 | 13.33 | 1.90  | OK | spec feature: push rib (spec: 0.5 tall x 0.6) 0.50; spec feature: push rib (spec: 0.5 tall x 0.6) 0.50; longest bridge 10.6 |
| drum | plusY_down | yes | 1 | 1.11 | 4.81  | OK | - |
| ribbon_clamp | top_down | yes | 1 | 0.11 | 0.90  | OK | spec feature: clamp ridge (spec: 0.3 tall; 0.4 wide inside the 0.8 notch around the ribbon) 0.40 |
| receiver_left | plusY_down | yes | 1 | 32.27 | 0.80  | **FAIL** | SUPPORT: 169 mm² unsupported at print Z 10.2 (x -1.8..12.1, y -24.7..24.0); SUPPORT: 611 mm² unsupported at print Z 12.6 (x 12.5..40.0, y -11.3..24.6); longest bridge 25.0 |
| receiver_right | minusY_down | yes | 1 | 31.70 | 0.80  | **FAIL** | SUPPORT: 159 mm² unsupported at print Z 10.2 (x -1.8..12.1, y -25.0..23.8); SUPPORT: 611 mm² unsupported at print Z 12.6 (x 12.5..40.0, y -25.5..10.4); SUPPORT: 43 mm² unsupported at print Z 10.8 (x 15.3..40.5, y -27.3..-25.5); longest bridge 25.0 |
| elevator | bottom_down | yes | 1 | 3.75 | 1.57  | OK | longest bridge 6.6 |
| lever | plusY_down | yes | 1 | 0.90 | 1.45  | OK | - |
| plunger | top_down | yes | 1 | 6.35 | 1.34  | **FAIL** | SUPPORT: 86 mm² unsupported at print Z 36.4 (x -10.4..-2.3, y -6.0..6.0); longest bridge 4.5 |
| paddle_pad | minusY_down | yes | 1 | 1.37 | 2.54  | OK | - |
| ring_hook | minusX_down | yes | 1 | 3.32 | 2.16  | OK | - |
| bench_base | bottom_down | yes | 1 | 51.74 | 2.70  | OK | longest bridge 2.4 |
| fit_coupon | bottom_down | yes | 2 | 19.58 | 0.80  | OK | - |
| bite_nominal | plusX_down | yes | 1 | 5.94 | 12.70  | OK | - |
| bite_min | plusX_down | yes | 1 | 5.18 | 12.20  | OK | - |
| bite_max | plusX_down | yes | 1 | 6.78 | 13.20  | OK | - |
| bite_wedge_test | plusX_down | yes | 1 | 5.82 | 12.70  | OK | - |
| drum_spacer | plusY_down | yes | 1 | 0.05 | 0.80  | OK | - |
| follower_springA | plusX_down | yes | 1 | 12.87 | 1.47  | OK | spec feature: push rib (spec: 0.5 tall x 0.6) 0.50; spec feature: push rib (spec: 0.5 tall x 0.6) 0.50; longest bridge 10.6 |

## 9.9 Envelope and mass

Assembled (state A, docked, pad at rest, ring hook fitted): X -53.0 → 140.8 (193.8), Y -25.2 → 14.6 (39.7), Z -20.0 → 53.2 (73.2).

| Part | Group | Material | Volume cm³ | Solid mass g |
|---|---|---|---|---|
| clip_tube | clip | PETG | 34.09 | 43.3 |
| end_cap | clip | PETG | 2.39 | 3.0 |
| gate | clip | PETG | 0.87 | 1.1 |
| follower | clip | PETG | 13.33 | 16.9 |
| drum | clip | PETG | 1.11 | 1.4 |
| ribbon_clamp | clip | PETG | 0.11 | 0.1 |
| drum_spacers | clip | PETG | 0.10 | 0.1 |
| receiver_left | receiver | PETG | 32.27 | 41.0 |
| receiver_right | receiver | PETG | 31.70 | 40.3 |
| elevator | receiver | PETG | 3.75 | 4.8 |
| lever | receiver | PETG | 0.90 | 1.1 |
| plunger | receiver | PETG | 6.35 | 8.1 |
| paddle_pad | receiver | TPU | 1.38 | 1.7 |
| ring_hook | receiver | PETG | 3.32 | 4.2 |
| **clip (cartridge) total** | | | 52.0 | 66.1 |
| **receiver total** | | | 79.7 | 101.1 |
| **clip + receiver, printed** | | | **131.7** | **167.1** |
| steel hardware (pins, spring B ribbon, return spring, screws, nuts) | | steel | | 8.1 |
| **empty device** | | | | **175.2** |
| **loaded, + 8 x 8 g bites** | | | | **239.2** |

Solid mass (100 % density, upper bound). At 4 perimeters + 30 % gyroid the printed mass is roughly 60-75 % of this. Gameplan target: ≤ 120 g and ≤ 120 cm³ per loaded clip - the clip cartridge alone is 52 cm³ of plastic and 130 g loaded (solid).

## 9.10 Force report

Paddle force = μ_wall·F + μ_bite·F + return-spring force, μ_wall = 0.1, μ_bite = 0.4. The return spring is taken at the **real rest pose** (pins on the loaded side of their holes, plunger bottom -1.00): installed length **27.0** at rest (26.8 with pins centred), **12.1** at the hard stop. Rest is the weakest point of the return stroke, so the sink-back check uses it.

| Spring | F (N) | friction (N) | return spring k / free | return force rest / pressed (N) | **paddle force start / end (N)** | > 6 N? | uneaten bite returns? rest force ÷ 0.5 F | sticky: ÷ 0.7 × 1.1 F | empty elevator returns? (> 0.2 F) |
|---|---|---|---|---|---|---|---|---|---|
| B | 1.47 | 0.73 | 0.13 / 38 | 1.43 / 3.37 | **2.17 / 4.10** | no | yes (1.95x) | yes (1.26x) | yes |
| A | 6.60 | 3.30 | 0.20 / 35 | 1.60 / 4.58 | **4.90 / 7.88** | **FLAG** | **no** (0.48x) | **no** (0.31x) | yes |
Return spring bought anywhere in the BOM range (spring B): installed 27.0 at rest, 12.1 pressed.

| free length | k (N/mm) | rest / pressed force (N) | paddle force start / end (N) | uneaten bite returns (÷ 0.5 F) | sticky (÷ 0.7 × 1.1 F) |
|---|---|---|---|---|---|
| 37 | 0.12 | 1.20 / 2.99 | 1.94 / 3.72 | 1.63x | 1.06x |
| 37 | 0.15 | 1.50 / 3.74 | 2.23 / 4.47 | 2.04x | 1.33x |
| 40 | 0.12 | 1.56 / 3.35 | 2.29 / 4.08 | 2.12x | 1.38x |
| 40 | 0.15 | 1.95 / 4.19 | 2.69 / 4.92 | 2.65x | 1.72x |

Spring B (final) passes: chin force well under 6 N, and an uneaten raised bite sinks back even with sticky food (μ_bite 0.6) and the spring 10 % strong. Spring A needs up to ~7.9 N and an uneaten bite does NOT sink back (keep A for high-force feed tests only).

### Feed margin (spring force at −13 % ÷ stack drag)

Usable force = spring force at −13 %, less the drum turning on its steel axle (μ 0.3 × pin radius ÷ coil radius = 4.3 % for B). Drag: 8 × 10 g bites at μ 0.6, times the contact factor k (sum of the contact normal forces ÷ weight: upright on the two R0.5 rail edges, or **leaning** and wedged against a side wall, see §9.11), plus the follower group (follower, drum, spacer rings, coil, axle; solid mass, an upper bound) at μ 0.4 on the rail tops. Drag at an incline t (mouth uphill) = g·[(μ·k·m_bites + μ_f·m_f)·cos t + (m_bites + m_f)·sin t]; the worst incline is where that peaks. Not modelled: the follower's pitch moment (the ribbon pulls through the axle at Z ≈ 8, the stack pushes back on the ribs at Z 10-24), which can add a few % of drag. 10 g bites are heavy (a nominal bite of 1.1 g/cm³ food is ~6.5 g): real margins scale up with lighter food.

| Spring | Bite width | k | follower group g | Earth level | Earth vertical (mouth up) | **Earth worst incline** | Moon level | Moon worst incline |
|---|---|---|---|---|---|---|---|---|
| B | min (18) | 1.25 | 20.9 | 1.82x | 1.24x | **1.02x** at 56° | 11.0x | 6.2x |
| B | min (18), **leaning** | 1.77 | 20.9 | 1.34x | 1.24x | **0.91x** at 47° | 8.1x | 5.5x |
| B | nom (19) | 1.09 | 20.9 | 2.05x | 1.24x | **1.06x** at 59° | 12.4x | 6.4x |
| B | nom (19), **leaning** | 1.75 | 20.9 | 1.35x | 1.24x | **0.91x** at 48° | 8.2x | 5.5x |
| B | max (20) | 1.02 | 20.9 | 2.18x | 1.24x | **1.07x** at 60° | 13.2x | 6.5x |
| B | max (20), **leaning** | 1.14 | 20.9 | 1.98x | 1.24x | **1.05x** at 58° | 12.0x | 6.4x |
| B | **worst width 18.59, leaning** | 3.13 | 20.9 | 0.79x | 1.24x | **0.66x** at 32° | 4.8x | 4.0x |
| A | min (18) | 1.25 | 24.3 | 8.07x | 5.39x | **4.48x** at 56° | 48.9x | 27.1x |
| A | min (18), **leaning** | 1.77 | 24.3 | 5.95x | 5.39x | **4.00x** at 48° | 36.0x | 24.2x |
| A | nom (19) | 1.09 | 24.3 | 9.06x | 5.39x | **4.63x** at 59° | 54.9x | 28.1x |
| A | nom (19), **leaning** | 1.75 | 24.3 | 6.00x | 5.39x | **4.01x** at 48° | 36.3x | 24.3x |
| A | max (20) | 1.02 | 24.3 | 9.58x | 5.39x | **4.70x** at 61° | 58.0x | 28.5x |
| A | max (20), **leaning** | 1.14 | 24.3 | 8.75x | 5.39x | **4.59x** at 58° | 53.0x | 27.8x |
| A | **worst width 18.59, leaning** | 3.13 | 24.3 | 3.52x | 5.39x | **2.95x** at 33° | 21.3x | 17.8x |

**Flag (1-g worst case):** with spring B the Earth margin is lowest with the mouth tilted uphill: 1.02x at ~56° for upright min-width bites; **0.66x at ~32° if min-width or nominal bites lean**; and at the worst leaning width (18.59, pinched between one wall and the opposite rail edge) **0.79x level / 0.66x at ~32°**. A margin below 1 means a stall is predicted. That stacks every worst case: sticky μ 0.6 on rails and walls, 10 g bites, spring 13 % weak, a rigid frictionless lean (real food deforms; friction resists the lean). The bench test decides (OPEN_ISSUES #14). On the Moon the margin is ≥ 4.0x in any orientation (the often-quoted ~12x is the level case).

### Bite 2 dragged up in state B

Bite 1 rising pulls bite 2 up by face friction μ_bite·P; bite 2 resists with its weight plus friction on its rear face, which carries P less its own rail friction in the worst case. Margin = resistance ÷ drag (> 1: bite 2 stays down), 10 g min-width bite:

| Spring | Earth | Moon |
|---|---|---|
| B | 1.111 | 1.019 |
| A | 1.026 | 1.004 |

Below ~1.05 it is marginal, but harmless: the rise is capped by the 0.65 gap to the clip roof and bite 2 drops back as soon as bite 1 stops moving.

## 9.11 Bites step down into the receiver (v1.1)

The bridge (X −2.1 → 0) and the cup at rest are both at Z 3.7 (`CUP_TOP_Z`), with a 0.2 edge break at X 0. A bite on the clip rails sits on the rails' R0.5 inner edges; under gravity the clip rests on its socket floor, 0.1 below centre. The rule: every rail seat ≥ `CUP_TOP_Z`, so a bite only ever steps **down** (a rigid upright bite climbing a 45° lead-in self-locks once bite-to-bite friction reaches ~0.43, however hard the spring pushes).

| Bite width | Clip | Rail seat Z | **Step down to the bridge** |
|---|---|---|---|
| min (18) | centred | 4.000 | **0.30** PASS |
| min (18) | on its floor (-0.1) | 3.900 | **0.20** PASS |
| nom (19) | centred | 4.291 | **0.59** PASS |
| nom (19) | on its floor (-0.1) | 4.191 | **0.49** PASS |
| max (20) | centred | 4.449 | **0.75** PASS |
| max (20) | on its floor (-0.1) | 4.349 | **0.65** PASS |

**Leaning bites (not covered by the rule above).** The rule assumes upright, centred bites. A rigid, **frictionless** 2-D check (`cad/lean.py`) lets a bite shift and lean about X; a whole stack can lean together because rotating about the stacking axis does not slide one face on the next. Upright is tested by energy: lean it 0.25° and let it roll freely on its two rail contacts, walls ignored (an R2 corner on an R0.5 edge acts like a four-bar linkage); if its centre of mass drops, upright is unstable. The walls then decide where the roll stops. Lowest-energy pose, clip on its floor:

| Bite width | Upright stable? (CoM change, 0.25° free roll) | Lowest-energy lean | CoM lower by | Contacts | k (Σ normals ÷ weight) | Lowest bottom point Z (at Y) | vs bridge top |
|---|---|---|---|---|---|---|---|
| min (18) | **no** (-0.79 µm) | 7.37° | 0.493 | wall+1, wall-1, rail-1 | 1.77 | 2.59 (Y 5.6) | -1.11 |
| nom (19) | **no** (-1.59 µm) | 2.75° | 0.176 | wall-1, rail+1, rail-1 | 1.75 | 3.67 (Y 6.7) | -0.03 |
| max (20) | **no** (-6.31 µm) | 0.37° | 0.014 | wall-1, rail+1, rail-1 | 1.14 | 4.28 (Y 7.8) | +0.58 |

- **min (18 wide): upright is unstable** (frictionless). It rolls 7.37° until it wedges against both side walls; its lowest corner ends 1.11 below the bridge top (clip on its floor); its contact forces add up to 1.77x its weight instead of 1.25x upright.
- **nom (19 wide): upright is unstable** (frictionless). It rolls 2.75° until it wedges against one side wall; its lowest corner ends 0.03 below the bridge top (clip on its floor); its contact forces add up to 1.75x its weight instead of 1.09x upright.
- **max (20 wide): upright is unstable** (frictionless). It rolls 0.37° until it wedges against one side wall; its lowest corner ends 0.58 above the bridge top (clip on its floor); its contact forces add up to 1.14x its weight instead of 1.02x upright.
- Only friction at the rails and walls keeps bites upright, and a jolt can tip them (every listed width is unstable upright).
- **Across the whole width band** (H 25.4, every 0.025): k = 18.00: 1.72, 18.10: 1.73, 18.20: 1.73, 18.30: 1.73, 18.40: 1.73, 18.50: 1.73, 18.60: 3.04, 18.70: 2.45, 18.80: 2.12, 18.90: 1.91, 19.00: 1.75, 19.10: 1.63, 19.20: 1.54, 19.30: 1.46, 19.40: 1.39, 19.50: 1.34, 19.60: 1.29, 19.70: 1.24, 19.80: 1.20, 19.90: 1.17, 20.00: 1.14. The worst is **3.13 at 18.59 wide**: just past the width where a bite can touch both walls, it pinches between one wall and the opposite rail edge, whose contact faces almost sideways, so the two forces fight each other. This is a sharp, geometry-sensitive jump in a rigid model, but it is the case to test: `bite_wedge_test.stl` is 18.6 wide.
- A leaning bite meets the bridge edge on one rounded R2 corner, 0.9-1.1 above the corner's lowest point (contact ~60° from vertical). It has to roll upright about its high-side rail against bite-to-bite face friction; a rough torque balance says that can self-lock at bite-to-bite friction of only ~0.2-0.4, no better than the climb v1.1 removed. The CAD can't settle it: **bench go/no-go #1 (sticky min, nominal and wedge-test bites, clip resting in the socket, all 8 cycled, level and at ~50° mouth-up) is the real test** (OPEN_ISSUES #14).

## 9.12 Return-spring solid length (v1.1)

Solid length = (n_active + 3)·d with n_active = G·d⁴ / (8·D³·k) (closed, unground ends; G = 79.3 GPa music wire; 302 SS is ~13 % softer, so fewer coils and shorter). It must be ≤ 10 and below the 12.1 pressed length, or the spring coil-binds before the flange reaches its hard stop and the lift is lost.

| Spring config | wire / OD / k | Solid length | ≤ 10 and < pressed? |
|---|---|---|---|
| B | 0.4 / 6.0 / 0.13 | 5.6 | PASS |
| A | 0.4 / 6.0 / 0.2 | 4.1 | PASS |

Over the BOM range for the spring-B return spring (k 0.12 → 0.15 N/mm):

| OD | wire | solid length at k 0.12 / 0.15 | |
|---|---|---|---|
| 5.5 | 0.4 | 7.6 / 6.3 | OK |
| 5.5 | 0.45 | 13.2 / 10.8 | **coil-binds** (≥ pressed length) |
| 6.0 | 0.4 | 6.0 / 5.1 | OK |
| 6.0 | 0.45 | 10.3 / 8.5 | **over 10** |
| 6.5 | 0.4 | 4.9 / 4.2 | OK |
| 6.5 | 0.45 | 8.2 / 6.9 | OK |

**0.4 wire meets the rule everywhere in the range.** Out of range: OD 5.5 with 0.45 wire reaches 13.2 (coil-binds); OD 6.0 with 0.45 wire reaches 10.3. So the "0.45 max" wire is only safe on a larger OD or a stiffer spring - buy 0.4.

## 9.13 Latch (§6.2, v1.1)

Socket clearance 0.1 below the clip, 0.3 above. Tooth bottom Z 32.80, notch floor Z 32.50 (clip centred).

| Clip position | Tooth engagement in the 1.0 notch | Tooth bottom → notch floor | Tongue strain when docking |
|---|---|---|---|
| on its socket floor (rest, gravity) | **0.60** | 0.40 | 1.41 % |
| centred | 0.70 | 0.30 | |
| floated up against the socket roof | 1.00 | **0.00** | 2.35 % |

Floated up, the tooth reaches the notch floor at exactly the moment the clip top reaches the socket roof: they touch, they never overlap (the clip-float poses in §9.1 confirm it), and the clip cannot rise further. Play in X 0.10; strain at 10.1 from the tongue root, PETG yield ~4 %. The tongue is 4.0 wide, in the -Y half only (OPEN_ISSUES #1).
