memorez1000enjoyer/CASA-EDB/(commit log)

2026-09-29 EBD Clip v1: parametric CadQuery model, kinematics, exports, verification harness
    Claude-Session: https://claude.ai/code/session_01CLd4arxTLnby1yV1fFNUxD
    [bench_base.step, bench_base.stl, bite_max.step, bite_max.stl, bite_min.step, bite_min.stl, bite_nominal.step, bite_nominal.stl]
2026-09-29 Review round 1 fixes: stripper strength, lift play, clip float lead-ins, printability, docs
    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
    [bench_base.step, bite_max.step, bite_min.step, bite_nominal.step, clip_tube.step, clip_tube.stl, clip_tube_viewslots.step, clip_tube_viewslots.stl]
2026-09-29 Review round 2 fixes: pivot press-fit + running lever fit, hole-play kinematics, follower front relief, clip-float poses, enforcers, docs
    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
    [bench_base.step, bite_max.step, bite_min.step, bite_nominal.step, clip_tube.step, clip_tube.stl, clip_tube_viewslots.step, clip_tube_viewslots.stl]
2026-09-29 Review round 3: independent pin-hole fits, fixed M2 clearance, follower relief 0.7, socket-head screws, stale numbers
    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
2026-09-29 Rebuild outputs after review round 3 (STLs, STEP, renders, VERIFICATION.md, zip)
    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
    [bench_base.step, bite_max.step, bite_min.step, bite_nominal.step, clip_tube.step, clip_tube.stl, clip_tube_viewslots.step, clip_tube_viewslots.stl]
2026-09-29 Review round 4 (convergence): doc fixes - reaming drills in BOM, run fit in README, CLR_PRESS note; rezip
    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
2026-10-06 v1.1 (Rev C follow-up): spring B default, bridge/cup at Z 3.7, socket floor 0.1, return spring k0.13/free38/0.40 wire, spacer ID, pocket bottom; new checks 9.11-9.13, feed margins, lean analysis; docs
    Applies EBD_v1.1_prototype.patch, with its hard-coded edge break turned into BRIDGE_LEADIN.
    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
2026-10-06 Receiver: carry the socket's top-edge chamfer along the stripper wall (0.37 corner sliver); denser wall sampling; reprint notes, 27.8 mm bridge
    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
2026-10-06 v1.1 outputs: spring-B default STLs/STEPs (spring A as _springA), states, renders, VERIFICATION.md (9.1-9.13), zip renamed EBD_Clip_v1.1_output.zip
    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
    [bench_base.step, bite_max.step, bite_min.step, bite_nominal.step, clip_tube.step, clip_tube.stl, clip_tube_viewslots.step, clip_tube_viewslots.stl]
2026-10-06 v1.1 review fixes: leaning-bite contact factor + axle friction in feed margins, bites ride with the clip in shift poses (+A/B/B' floor and Y poses), TPU-lip cap, socket-floor note, docs
    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
2026-10-06 v1.1 outputs after review fixes: 258 poses clean, feed margins incl. leaning bites and axle friction, zip without caches
    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
    [bench_base.step, bite_max.step, bite_min.step, bite_nominal.step, clip_tube.step, clip_tube.stl, clip_tube_viewslots.step, clip_tube_viewslots.stl]
2026-10-06 v1.1 outputs: wedge-test bite STL, width-band lean sweep in VERIFICATION, Moon figure fix
    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
    [bench_base.step, bite_max.step, bite_min.step, bite_wedge_test.step, bite_wedge_test.stl, clip_tube.step, clip_tube.stl, clip_tube_viewslots.step]
